slahiri/sparky/docs/images/part_collar.png

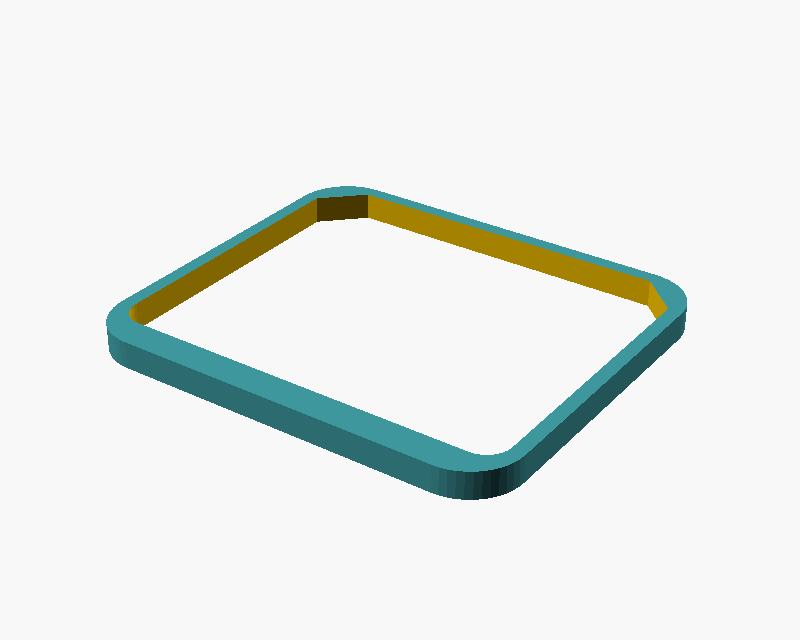
docs/images/part_collar.png
