slahiri/sparky/docs/images/part_face.png

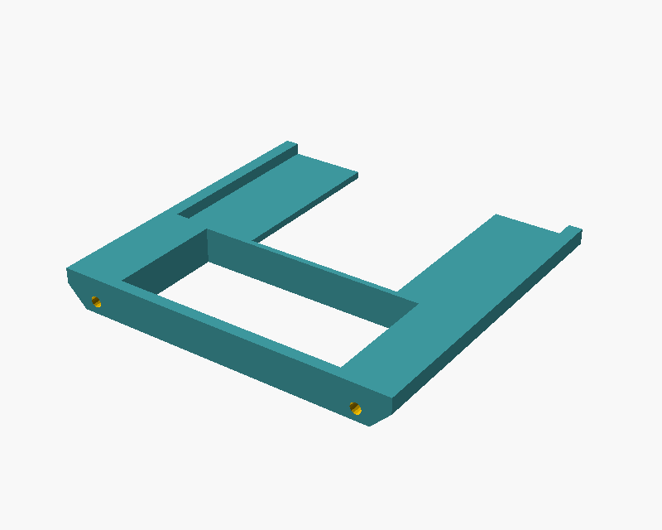
docs/images/part_face.png
