slahiri/sparky/docs/images/part_front.png

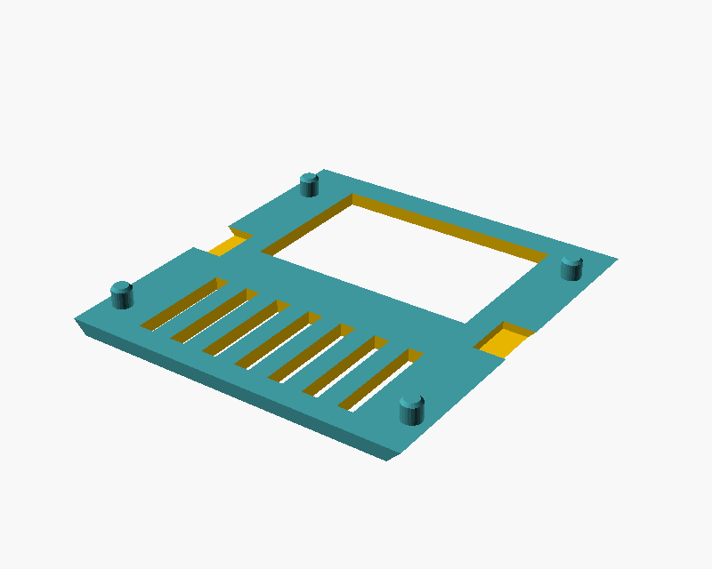
docs/images/part_front.png
