slahiri/sparky/docs/images/part_shell.png

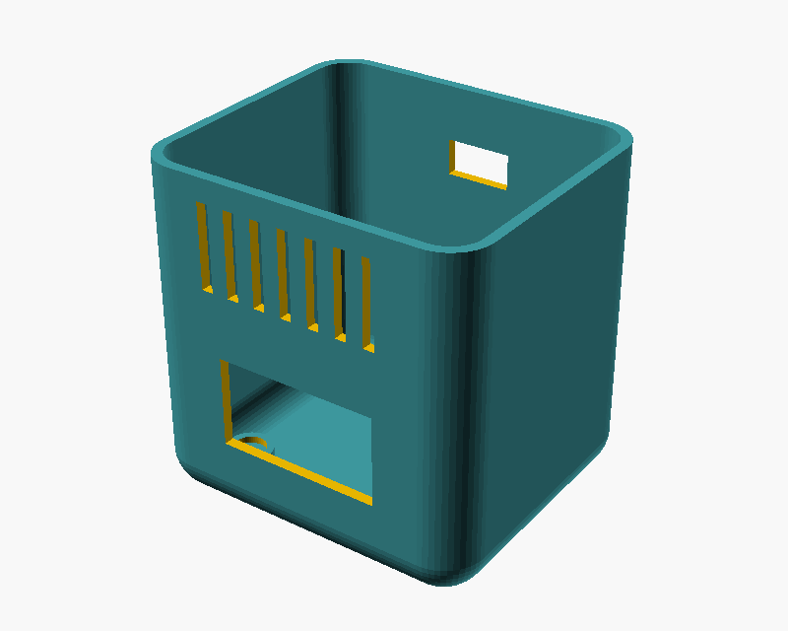
docs/images/part_shell.png
