slahiri/sparky/docs/assembly.md

# Assembly

Wire everything outside Sparky first, then slide it in. Only the shell comes off; the rest goes in from the back and the front.

## 1. Set the magnets (do this first)

Every magnet goes in with its **north face pointing up**. Glue 4 magnets into the tops of the rack's two towers, let 4 more snap onto them, put a drop of glue in each shell ceiling boss and lower the shell straight down onto them. Hold for 30 seconds. The shell's magnets end up facing the right way automatically.

## 2. Pins

Push 5 mm pieces of 1.75 mm filament into the pin holes: two at the back of the rack's bottom (for the collar) and two at the front of the rack floor (for the face frame).

## 3. Prepare the modules

1. Plug the jumpers onto the MPU-6050, the amp, the mic and the touch pad (see [Wiring](wiring.md)).
2. Screw the speaker wires into the amp's terminal.
3. Plug every jumper onto the expansion board, with the four Y-splitters on the shared lines.

## 4. Top sensors

1. **Mic:** drop the round INMP441 into its pocket on the top, chip side down, so its sound hole faces up. It sits on a thin rim; its pins hang through the opening.
2. **Touch pad:** lay the TTP223 over the rectangular opening at the back.
3. Feed both sets of wires down the channel at the back.

## 5. Slide in from the back

1. Drop the collar over the rack onto its pins.
2. Slide the **MPU-6050** (left, header at the back) and the **amp** (right, terminal at the front) into the two grooves on the middle plate until they hit the front stops.
3. Optional: slide a **LiPo** in along either side wall, under the plate.
4. Slide the **ESP32 board** in along the floor rails, USB-C facing back, until it stops. All the wires drop down the back channel to it.

## 6. The front

1. Stand the **face frame** on the two floor pins at the front.
2. Put the **speaker** into its pocket, cone forward. The two posts on the rack floor stop it from behind.
3. Slide the **display** into its groove, glass forward, pins at the top, and plug its wires on.
4. Press the **front plate** on: its 4 pegs push into the frame. To take it off, lever it at the notch on either side.

## 7. Close it

Lower the **shell** over everything; it snaps to the towers and holds the face frame and collar in place. To open it, pull the shell straight up.
