slahiri/sparky/docs/images/sparky_assembled.png

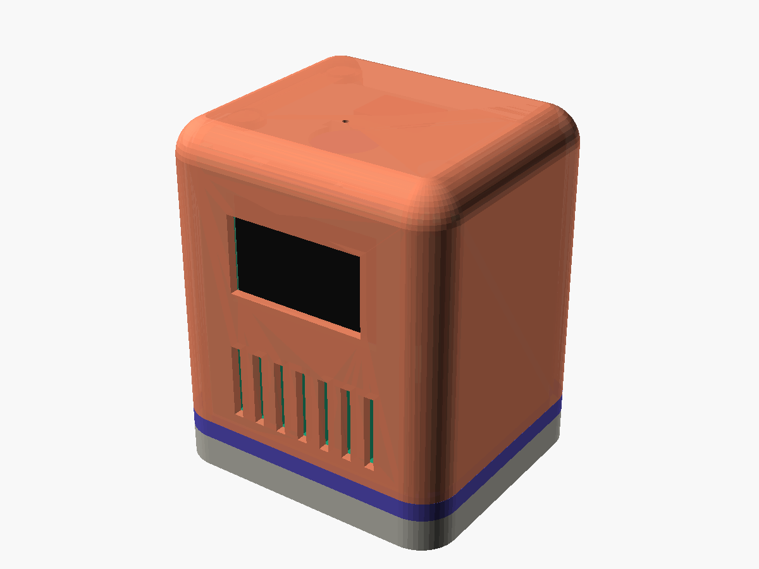
docs/images/sparky_assembled.png
