slahiri/sparky/(commit log)

2026-10-16 Sparky v0.1.0: modular magnetic ESP32-C3 desk buddy
    Parametric OpenSCAD source (shell, collar, rack, base, lid), generated
    STLs, PlatformIO hardware-test firmware, BOM, wiring and build guide.
    [base.scad, bom.csv, collar.scad, config.scad, lid.scad, rack.scad, shell.scad, sparky.scad]
2026-10-16 Build STLs in CI, publish releases on tags, add contributor files
    - CAD workflow exports all STLs and renders on every push/PR (artifacts)
    - Release workflow publishes STLs, renders and firmware on v* tags
    - STLs are no longer committed
    - PR template, CODEOWNERS, Code of Conduct, Dependabot for actions
    [sparky_base.stl, sparky_collar.stl, sparky_lid.stl, sparky_rack.stl, sparky_shell.stl]
2026-10-16 Removable crown on dovetail rails; fix rack/collar corner clash
    The rack's top is now a separate crown that slides in from the back on
    two dovetail rails, so the rack can be wired from above. The shell
    magnets move into the 4 mm crown. Interference check of every mating
    pair found the rack corners digging into the collar's R4 opening; the
    rack footprint now has R3.8 corners.
    [bom.csv, config.scad, crown.scad, rack.scad, shell.scad, sparky.scad]
2026-10-16 Animated explode GIF as the README hero
    scripts/render_gif.sh renders 50 OpenSCAD frames (ease in/out, camera
    pulls back) and assembles a 480 px looping GIF with ImageMagick.
    Exploded spacing widened so the crown shows between rack and shell.
    [sparky.scad]
2026-10-16 v0.2 layout: slide-in, solderless, support-free
    Every board now slides into its own groove and plugs together with
    Dupont wires, so Sparky is wired outside and then slid together.
    - New parts: face frame (display groove + speaker behind a front
    grille), middle plate (MPU-6050 on top, amp underneath, corner wire
    holes) and a drop-in lid (round INMP441 pocket + TTP223 pad). The
    dovetail crown and the battery lid are gone.
    - Rack: open back, board rails, plate ledges, a LiPo 503040 bay on each
    side, and two towers carrying the shell magnets.
    - Base is a simple 5 mm plate on feet. Body is 64.4 x 56.6 x 76 mm;
    shell is R8 outside, R6 inside.
    - SW420, LED and power switch removed; MPU-6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
    [base.scad, bom.csv, collar.scad, config.scad, crown.scad, face.scad, lid.scad, plate.scad]
2026-10-16 Fixed middle plate; drop the battery ribs
    The middle plate is now part of the rack. Only the boards slide: the
    MPU-6050 (left) and the amp (right) slide into grooves on top of it from
    the back. Both grooves sit on top so the rack still prints without
    supports (the plate is a 55 mm bridge between the walls).
    - Removed the separate plate part and the LiPo bay ribs; a LiPo slides
    in along either side wall
    - Towers start at X +-19.9 so the gussets clear the sensor plugs; the
    lid is 39.4 mm wide
    - Docs, BOM, wiring labels, renders and GIF updated
    [bom.csv, config.scad, plate.scad, rack.scad, sparky.scad]
2026-10-16 Solid rack bottom, fixed top, removable front plate
    - Rack is one print: the base is now its solid bottom (no base part,
    no base magnets; 8 magnets total) and the top is fixed, holding the
    mic and touch pad over openings so their wires come up from below
    - Middle plate and top stop 6 mm short of the open back: wire channel
    - Face frame: the speaker sits in an open pocket; two posts on the rack
    floor stop it from behind
    - New front plate part: display window + speaker grille, presses onto
    the face frame with 4 round pegs, pull notches on both sides
    - Five printed parts: shell, collar, rack, face, front
    - check_fit.sh no longer re-reads a stale result when a pair is clear
    - Docs, BOM,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
    [base.scad, bom.csv, collar.scad, config.scad, face.scad, front.scad, lid.scad, rack.scad]
