slahiri/sparky/(notices)

Notices in the files:
README.md:
Hardware: CC BY-SA 4.0
